loliweive/Rick_RGB/developing document/RGB色棒规格.pdf

RGB 色棒功能表

模式选择 | KEY1 | KEY2
OPTION=X | 色调类型+ | 色调类型- | 此为常亮
OPTION=0 | 色调类型+(循环) | 色调模式更换(循环)

色调模式
1 | 常亮
2 | 半亮
3 | 3S 渐明渐暗(PWM?)
4 | 爆闪(10HZ)

色调类型(5 位 PWM,要方便改动)
| R(红) | G(绿) | B(蓝)
1 | 32 | 0 | 0
2 | 0 | 32 | 0
3 | 0 | 0 | 0
4 | 32 | 32 | 32
5 | 32 | 0 | 32
6 | 0 | 32 | 32
7 | 32 | 32 | 32
8 | 32 | 16 | 16
9 | 32 | 8 | 8
10 | 32 | 4 | 4
11 | 32 | 16 | 4
12 | 16 | 32 | 16
13 | 8 | 32 | 8
14 | 4 | 32 | 4
15 | 4 | 32 | 16
16 | 16 | 16 | 32
17 | 8 | 8 | 32
18 | 4 | 4 | 32
19 | 4 | 16 | 32
20 | 4 | 8 | 16
