loliweive/Rick_RGB/Schematic/RGB原理图.pdf

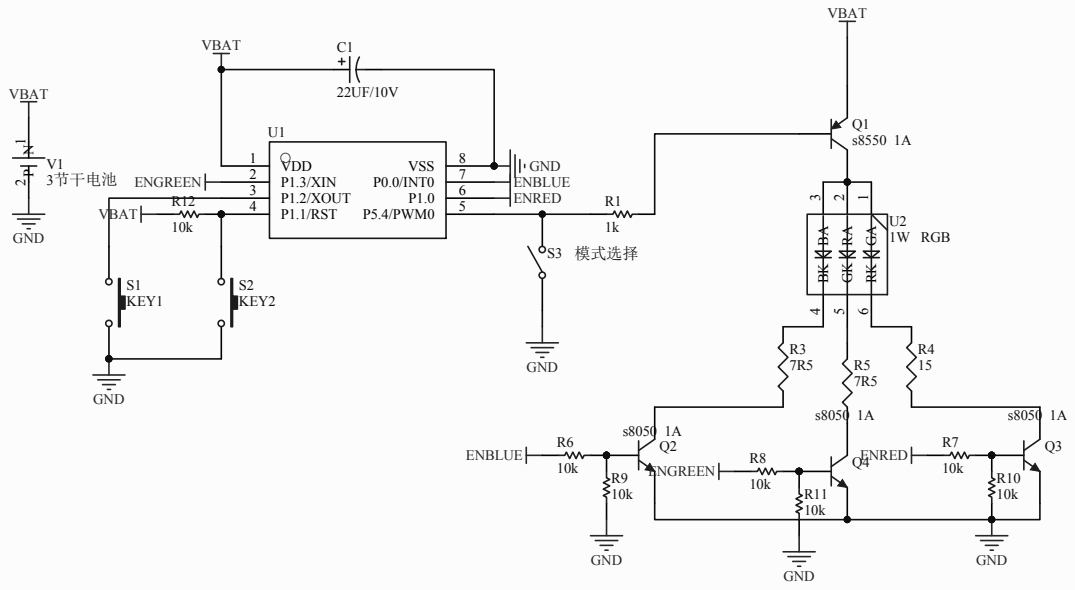
[picture p1: page 1]
