loliweive/Rick_RGB/(list of files, drawings)

Other design files:
Schematic/RGB棒.SchDoc
