loliweive/Rick_RGB/(commit log)

2016-07-10 Delete led.inc
    no need
2016-07-14 Add files via upload
    1.fix the bug--last too long and blinking in the breathe mode.
    2.modify the feature--always detect the key2,and whenever it changes,mode1 value will be cleared,so it will go to always light mode.
    3.decrease the set_vol_duty from 100 to 64,to keep the same as led_duty,otherwise,it will flash because of unsyn.
    [MAIN.ASM]
